AgentD/ADAM-1/(list of files, drawings)

Other design files:
cpu/adder.pcb
cpu/log.pcb
cpu/memio.pcb
cpu/psw.pcb
cpu/reg.pcb
cpu/shift.pcb
fp/fp0.pcb
fp/fp1.pcb
