AgentD/ADAM-1/(commit log)

2015-04-20 Add shift register module
    [adder.pcb, const.pcb, log.pcb, reg.pcb, shift.pcb]
2015-04-29 Remove floating copper planes
    To conserve etching agent, large copper planes were left on the PCBs.
    Some of those planes were left unconnected, i.e. floating, thus acting
    as a capacitive coupling between distant signal lines. Those planes are
    now connected to VCC or GND.
    [const.pcb, log.pcb, reg.pcb]
2015-05-01 Add memory & I/O module
    [adder.pcb, const.pcb, log.pcb, memio.pcb, reg.pcb, shift.pcb]
2015-06-21 Minor design changes
    - Shift register uses B register instead of A register
    - Constant module does not need +/-2, but needs addresses
    of interrupt vectors
    [shift.pcb]
2015-06-26 Add decode module
    [decode.pcb]
2015-06-26 Make REGR control input low active
    [decode.pcb, reg.pcb]
2015-06-28 Shrink decode board
    [decode.pcb]
2015-07-01 Add select line for status word
    [decode.pcb]
2015-07-01 Cleanup on decode PCB, add ground/VCC planes
    [decode.pcb]
2015-07-12 Add PSWOE line to all PCBs
    [adder.pcb, const.pcb, log.pcb, memio.pcb, reg.pcb, shift.pcb]
2015-07-17 Remodeled decoding logic
    - Additional source address lines (A3 and A4)
    - register file triggered by A3 and A4 states
    - decoder generates control signals from A3 and A4 for other modules
    - adder uses LOG activation lines
    - LOG activation lines renamed to ALU
    [adder.pcb, const.pcb, decode.pcb, log.pcb, memio.pcb, reg.pcb, shift.pcb]
2015-08-02 Map constants to A3=0, A4=0. Use 74HC541 as buffer for consants
    - 74HC541 can decode address A3=0, A4=0
    - Have some of them anyway
    - Need fewer total parts
    - Need fewer bus control lines
    [adder.pcb, const.pcb, decode.pcb, log.pcb, memio.pcb, reg.pcb, shift.pcb]
2015-08-08 Divide PCB and circuit description files up to subdirectories
    [adder.pcb, const.pcb, decode.pcb, log.pcb, memio.pcb, reg.pcb, shift.pcb]
2015-09-19 Split data and control bus
    [adder.pcb, const.pcb, decode.pcb, log.pcb, memio.pcb, reg.pcb, shift.pcb]
2015-10-17 Add (currently) finalized version of software architecture
2015-10-27 Shrink PCB layouts to OSHPark design rules
    [adder.pcb, const.pcb, decode.pcb, log.pcb, memio.pcb, reg.pcb, shift.pcb]
2015-11-03 Unify drill hole sizes & annulus ring sizes
    [adder.pcb, const.pcb, decode.pcb, log.pcb, memio.pcb, reg.pcb, shift.pcb]
2015-11-13 Simplify assembly syntax for easier parsing
2015-11-20 Add bridge module
    [adder.pcb, bridge.pcb, const.pcb, decode.pcb, log.pcb, memio.pcb, reg.pcb, shift.pcb]
2015-11-21 Assembler simplification
2015-11-21 Remove '$' prefix for register names
    Was intended to simplify assembly translation. Turned out to only
    complicate things.
2015-11-25 "Remove" silk-screen part designators for diode matrix
    [const.pcb]
2015-11-28 Fix traces dangerously close to pads
    First patch of PCBs arived (adder, reg, decode). Two traces turned out
    to be very close to capacitor pads. Because of the very large solder
    mask holes, those traces are as a result also exposed.
    This patch moves those traces a little further away from the pads.
    [adder.pcb, reg.pcb]
2015-11-29 Remove interrupt flags from status register
    Implement interrupt controller as peripheral device.
2015-12-01 Connected remaining CBUS lines on bridge
    - Lines will be used
    - Further cross wirings (after adder and shift) very unlikely
    [bridge.pcb]
2016-01-12 Add character string directives to the assembler
2016-01-14 Redesign interrupt/trap behaviour
    - Constant modules contain 3 "control registers"
    - Allows overriding interrupt & syscall handler address
    - Kernel stack pointer is backed up in CR2 when entering
    user mode and restored when entering kernel mode
    - R6 can be used both in kernel and user space
    [const.pcb]
2016-02-21 Minor clarification/documentation update
    - Specify edge sensitive latching behaviour of control lines
    - Explicitly label WC line on all modules
    [adder.pcb, bridge.pcb, decode.pcb, log.pcb, memio.pcb, reg.pcb, shift.pcb]
2016-03-27 Add front-panel LED/switch module
    [fp0.pcb, memio.pcb]
2016-03-27 Add rough outlines of micro code assembler
2016-05-16 Update PCBs tp full 16 bit on DIN41612 bus
    [adder.pcb, bridge.pcb, const.pcb, decode.pcb, fp0.pcb, log.pcb, memio.pcb, reg.pcb]
2016-06-20 Revert deletion of fp0 board, adjust to new design
    [fp0.pcb]
2016-07-05 Modify register module for re-use as constant module
    Modifications:
    - Jumpers to configure address range when reading. Allows mapping
    to 10xxx or 00xxx (or 0*xxx if jumpers are in invalid position).
    - Jumper to configure write strobe to either WC or REGW
    - Jumper to only allow write if USR flag is low
    Pro:
    - Same PCB can be used for constant module and register module
    - Lower production costs
    - Fewer designs to maintain
    - More flexible, as constant values can be changed easily
    Cons:
    - Actual constants have to be initialized on machine bootstrap
    [const.pcb, reg.pcb]
2016-08-07 Add zero-detection & carry selection to shift board
    [shift.pcb]
2016-08-13 Add status word module
    [psw.pcb]
2016-08-15 Copy extended CPU bus pinout from PSW to other PCBs
    [adder.pcb, log.pcb, reg.pcb, shift.pcb]
2016-08-17 Complete redesing of memio board
    [memio.pcb]
2016-08-17 Bus documentation update
    [adder.pcb, log.pcb, psw.pcb, reg.pcb, shift.pcb]
2016-09-02 Move frontpanel PCB stuff to fp/ directory
    [fp0.pcb]
2016-09-12 Add PSW frontpanel connector to memio board
    [memio.pcb]
2016-09-12 Cleanup messy wiring on memio board
    [memio.pcb]
2016-09-12 Add PSW control lines to frontpanel connectors
    [memio.pcb]
2016-09-12 Restructure directory hirarchy
    - Move "pcb" directory containing CPU pcb desgings to "cpu" directory
    - Rename documentation accordingly
    - Include 00-INDEX file with file/directory descriptions
    - Restructure documentation
    [adder.pcb, log.pcb, memio.pcb, psw.pcb, reg.pcb, shift.pcb]
2016-09-16 Add seperate frontpanel latch & display board
    [fp1.pcb]
2016-09-16 Fix pin numbering
